belakiano/Ecovoz/caixa/desenho_tecnico.png

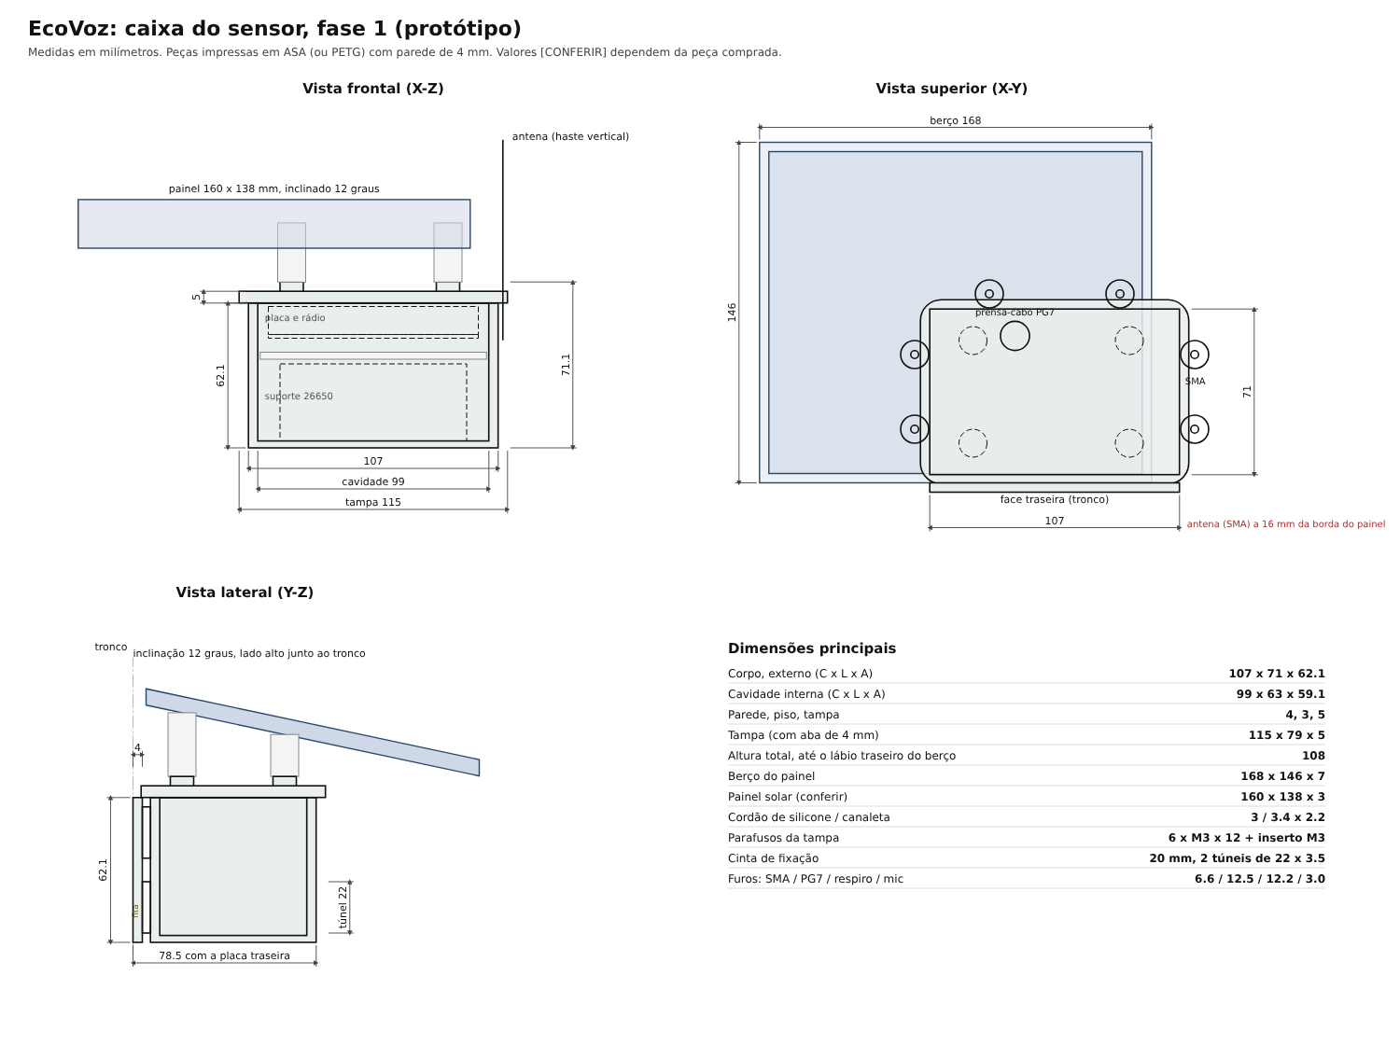
caixa/desenho_tecnico.png
