belakiano/Ecovoz/caixa/imagens/01_montada_frente.png

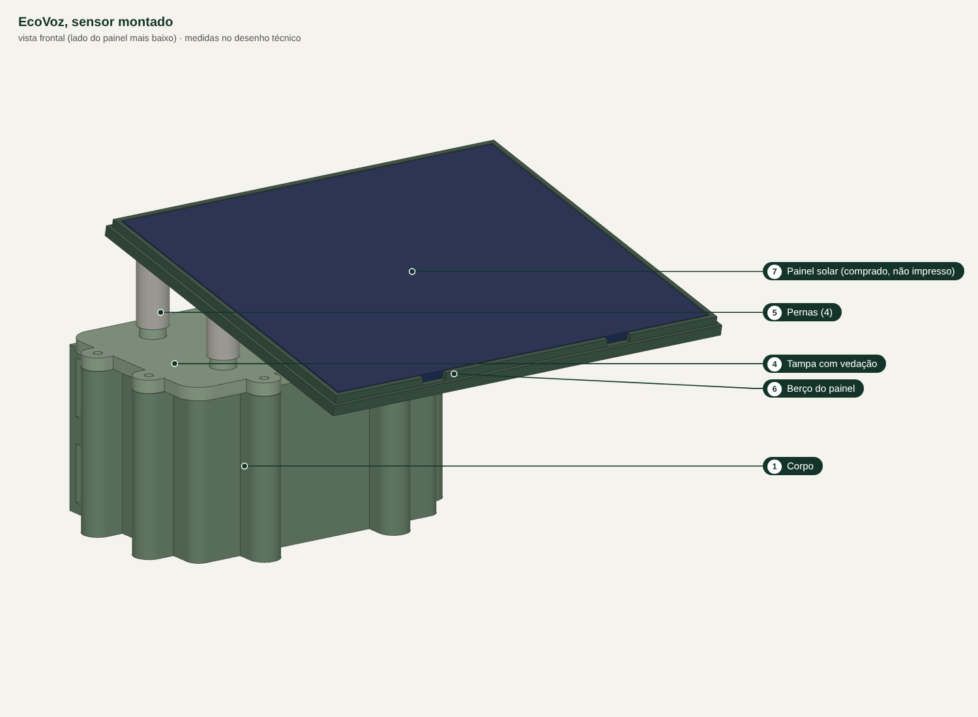
caixa/imagens/01_montada_frente.png
