belakiano/Ecovoz/caixa/imagens/02_montada_tras.png

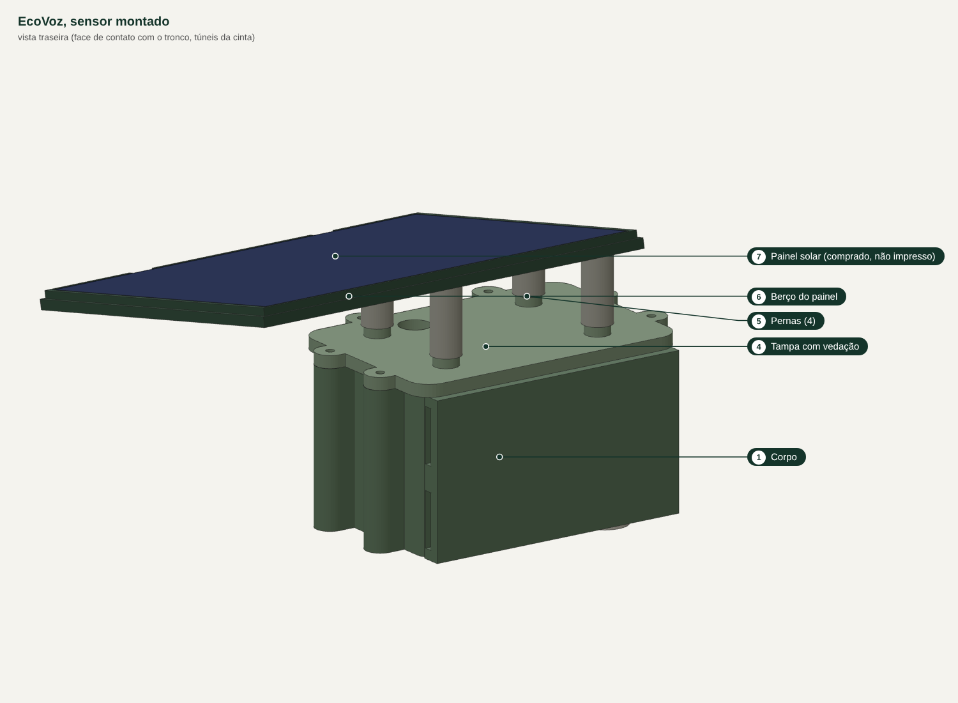
caixa/imagens/02_montada_tras.png
