belakiano/Ecovoz/caixa/imagens/04_aberta.png

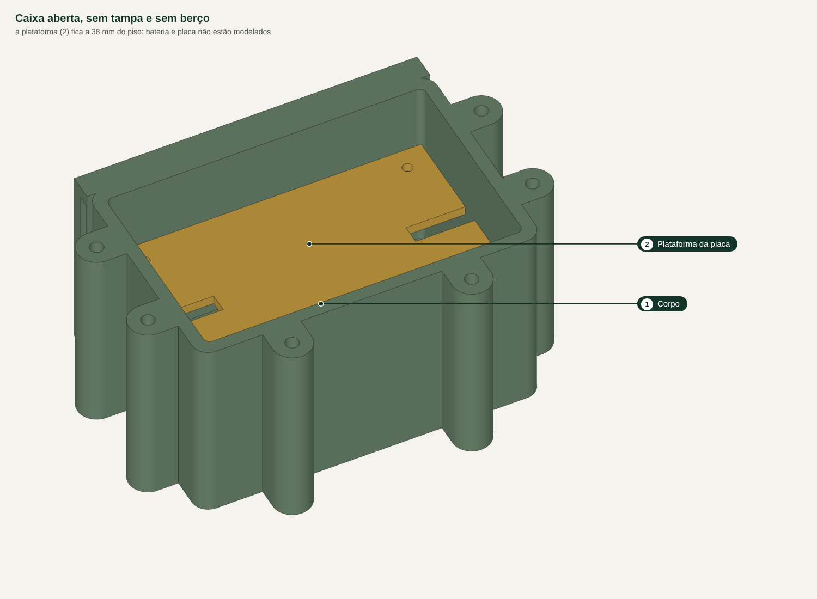
caixa/imagens/04_aberta.png
