belakiano/Ecovoz/docs/diagrama_operacao.png

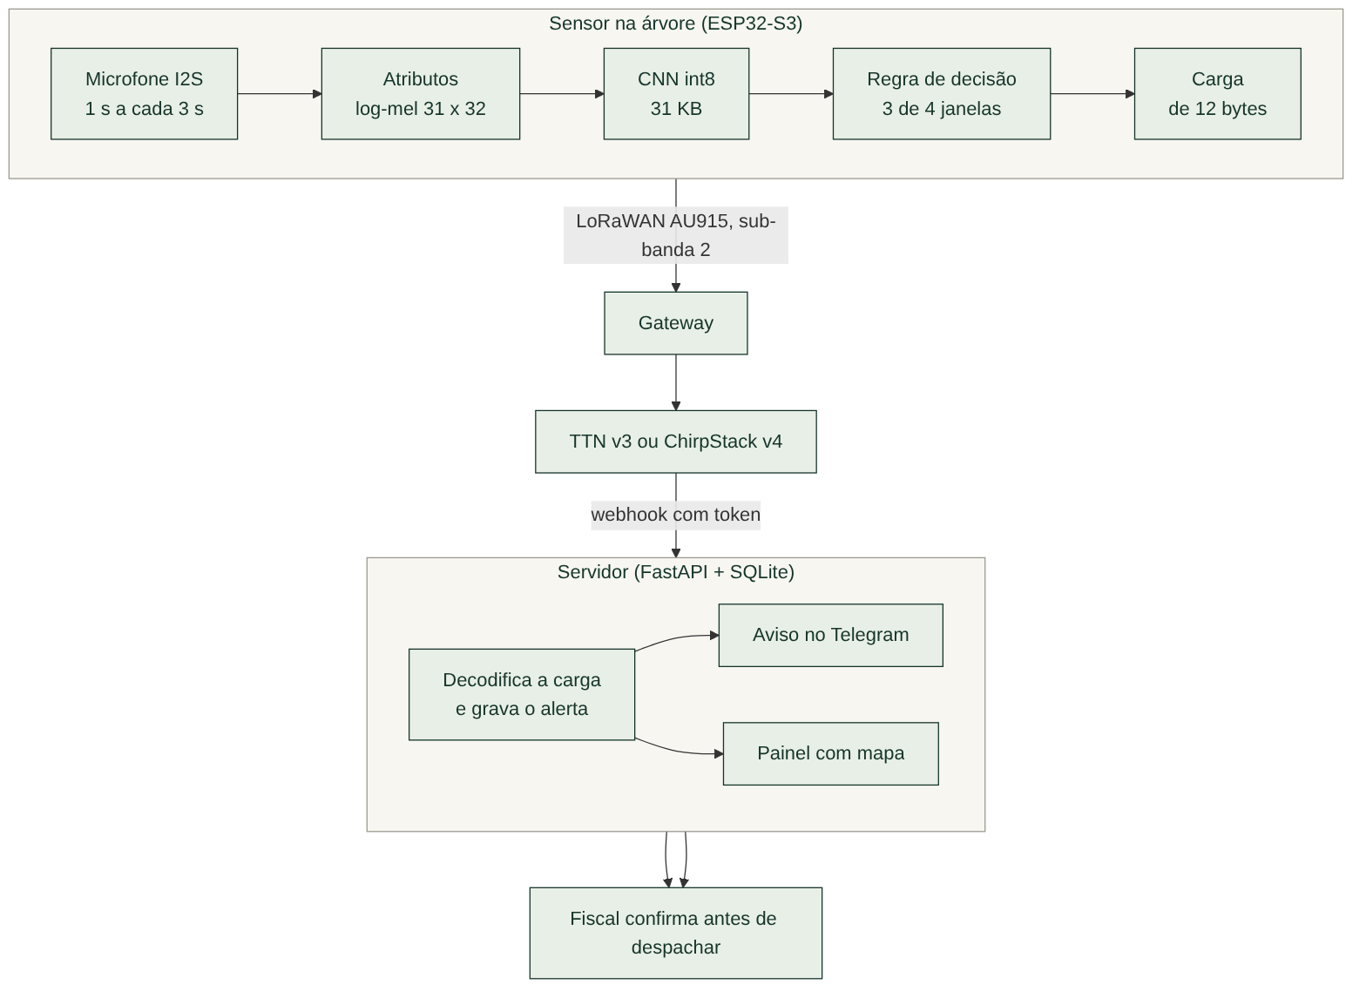
docs/diagrama_operacao.png
