belakiano/Ecovoz/caixa/lista_de_materiais.csv

Item | Especificação | Quantidade | Função | Observação | Preço unitário (R$) | Fonte e data da cotação
Controle | Placa de desenvolvimento ESP32-S3 (ex.: ESP32-S3-DevKitC-1) | 2 | Microcontrolador, inferência TinyML e controle do rádio | 1 de reserva. Na bancada o consumo da placa de desenvolvimento é muito maior que o do projeto final: medir só o chip depois.
Rádio | Módulo LoRa SX1262 915 MHz (ex.: Ebyte E22-900M22S) com cabo u.FL para SMA | 2 | Enlace LoRaWAN AU915 até o gateway | Conferir na folha de dados o TCXO e os pinos RXEN/TXEN.
Antena | Antena 915 MHz 3 dBi, haste flexível, conector SMA macho, com adaptador em ângulo reto | 2 | Irradiação do sinal | Instalada na vertical, acima da copa quando possível.
Conector | SMA fêmea de painel, vedado com anel O-ring, furo de 6,6 mm | 2 | Passagem da antena pela parede | Conferir o diâmetro de rosca do modelo comprado.
Microfone | Microfone MEMS I2S (INMP441 ou equivalente) em placa de 14 x 14 mm | 3 | Captação do áudio | 2 de reserva. Furo acústico de 3 mm.
Proteção acústica | Disco de membrana hidrofóbica de ePTFE, 9 mm, adesivo, e espuma de proteção contra vento de 14 mm | 6 + 3 | Impede água no microfone e reduz ruído de vento | Não vedar o furo com fita comum: abafa o som.
Posição | Módulo GNSS (ex.: u-blox NEO-M8N com antena cerâmica) | 1 | Marcar a posição na instalação (ligado só nessa hora) | Opcional na fase 1: a posição pode ser cadastrada pela serial.
Bateria | Célula LiFePO4 26650 de 3,2 V e cerca de 3000 mAh, com módulo de proteção | 2 | Armazenamento de energia | LiFePO4 tolera melhor calor e ciclos que íon-lítio comum. 1 de reserva.
Suporte da bateria | Suporte 1 x 26650 com fios | 2 | Fixação da célula (80 x 33 x 33 mm) | [CONFERIR] dimensões do suporte comprado.
Carregador solar | Módulo carregador com MPPT para LiFePO4 (candidato: baseado no bq24650, ajustado a 3,6 V) | 1 | Carga da bateria pelo painel | Candidato, conferir a folha de dados e o ajuste da tensão final de carga.
Regulador | Regulador buck-boost de 3,3 V e baixa corrente de repouso (candidato: TPS63802) | 1 | Alimentação do microcontrolador e do rádio | Candidato, conferir corrente de repouso medida na placa.
Proteção elétrica | Diodo supressor de surtos (TVS) na entrada solar e fusível rearmável de 1 A | 1 + 1 | Proteção contra surtos e curto
Painel solar | Painel de 6 V e 3 W, cerca de 160 x 138 x 3 mm, com fios | 1 | Geração de energia | [CONFERIR] medidas. O berço é parametrizado: se mudar o painel, altere caixa/parametros.py.
Placa universal | Placa perfurada ou de protótipo 90 x 56 mm | 2 | Montagem da eletrônica (fase 1) | A placa de circuito própria fica para a fase seguinte.
Espaçadores | Espaçador M3 de 6 mm, fêmea-fêmea, e parafuso M3 x 6 | 4 + 8 | Fixação da placa na plataforma
Impressão 3D | Filamento ASA (ou PETG) para uso externo, cor verde-oliva ou marrom fosca | ~0,4 kg | Corpo, tampa, plataforma, berço e pernas | Massa das peças estimada em 215 g com preenchimento de 25 a 40 por cento.
Inserto | Inserto roscado de latão M3 para fixação a quente (furo de 4,2 mm, 5 a 6 mm de comprimento) | 10 | 6 da tampa e 4 das pernas
Parafuso da tampa | Parafuso M3 x 12, aço inox | 6 | Fechamento da tampa
Parafuso das pernas, dianteiras | Parafuso M3 x 25, aço inox | 2 | Fixa berço e perna ao bloco da tampa | Alcance calculado 25.8 mm, furo cego de 6 mm de inserto.
Parafuso das pernas, traseiras | Parafuso M3 x 35, aço inox | 2 | Idem | Alcance calculado 35.2 mm. Conferir com paquímetro antes de apertar.
Vedação da tampa | Cordão redondo de silicone, diâmetro 3 mm | 0,4 m | Veda a tampa na canaleta de 3,4 x 2,2 mm | Cortar com 1 a 2 mm de sobra e emendar com cola de silicone.
Respiro | Respiro M12 x 1,5 com membrana de ePTFE | 1 | Equaliza a pressão e evita condensação sem entrar água | Furo de 12,2 mm na face +Y.
Prensa-cabo | Prensa-cabo PG7 com vedação | 1 | Passagem do cabo do painel | Furo de 12,5 mm na tampa.
Fixação à árvore | Cinta de nylon de 20 mm com fivela de came, 1,5 m | 1 | Prende a caixa ao tronco pelos túneis traseiros | Não usar prego nem parafuso no tronco.
Almofada | Adesivo de borracha EPDM de 3 mm, 105 x 40 mm | 1 | Ajuste da placa traseira ao tronco e antiderrapante
Colagem | Fita VHB (ou silicone neutro) para o painel e silicone neutro para vedação do cabo | 1 | Fixa o painel no berço
Secante | Sachê de sílica gel | 2 | Reduz umidade interna | Trocar a cada manutenção.
Cabos | Fio de silicone 22 AWG, conectores JST-PH e termorretrátil | 1 jogo | Ligações internas
Teste: energia | Medidor de corrente de baixa faixa (ex.: perfilador de corrente) ou multímetro com faixa de microampere | 1 | Medir consumo por modo (marco M5) | Sem isso a autonomia fica sem prova.
Teste: rádio | Gateway LoRaWAN AU915 (ou cobertura de gateway existente) e conta em servidor LoRaWAN | 1 | Marco M4 | Verificar sub-banda configurada.
Teste: áudio | Gravador de referência e fonte sonora de teste autorizada; calibrador acústico de 94 dB SPL (opcional) | 1 | Coletar dados próprios e calibrar o nível
