belakiano/Ecovoz/caixa/stl/anel_microfone.stl

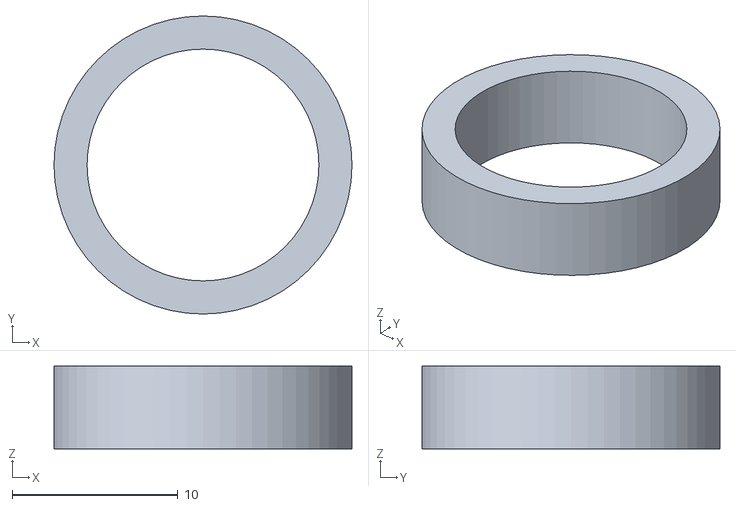
[picture p12: CAD file, 2026-11-03]
caixa/stl/anel_microfone.stl
18.0 x 18.0 x 5.00
