belakiano/Ecovoz/caixa/stl/berco_painel.stl

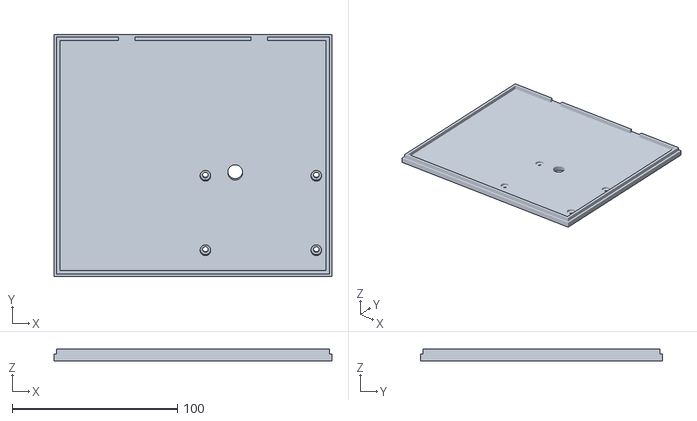
[picture p13: CAD file, 2026-11-03]
caixa/stl/berco_painel.stl
168.0 x 146.0 x 7.00
