belakiano/Ecovoz/caixa/stl/corpo.stl

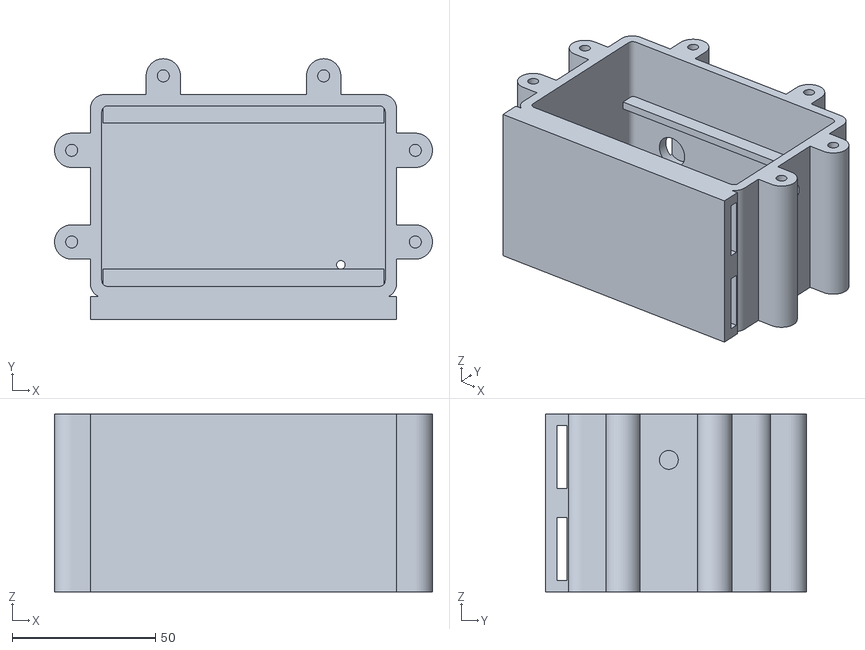
[picture p14: CAD file, 2026-11-03]
caixa/stl/corpo.stl
132.0 x 91.0 x 62.1
