belakiano/Ecovoz/caixa/stl/perna_dianteira.stl

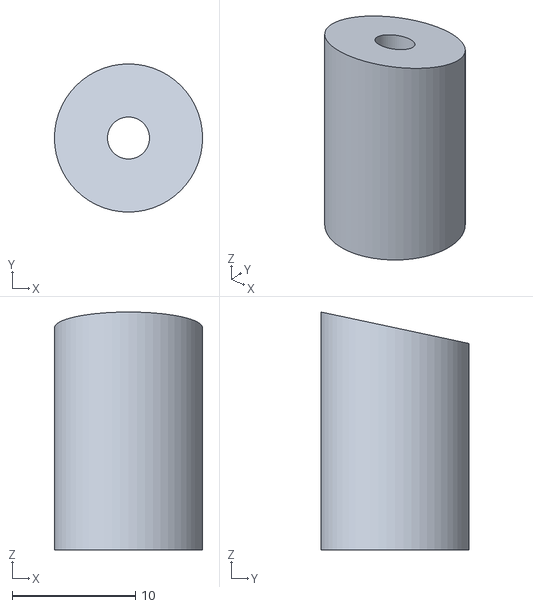
[picture p15: CAD file, 2026-11-03]
caixa/stl/perna_dianteira.stl
12.0 x 12.0 x 19.3
