belakiano/Ecovoz/caixa/stl/plataforma.stl

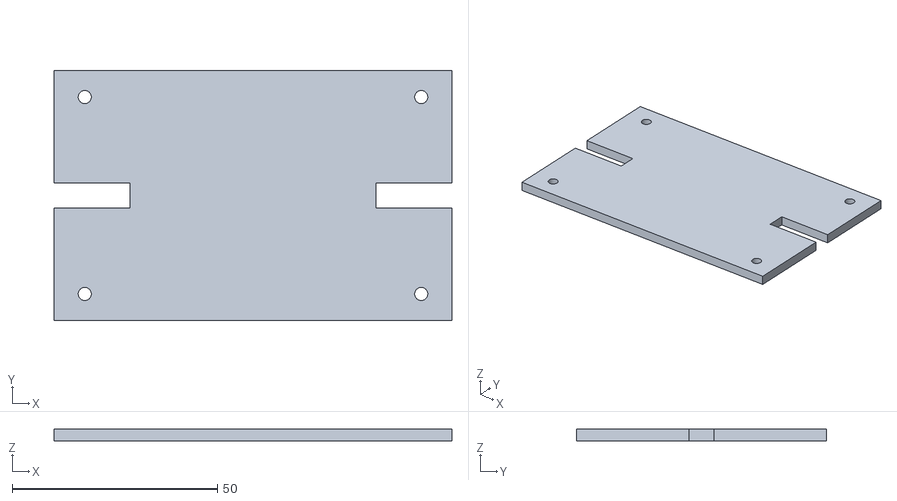
[picture p16: CAD file, 2026-11-03]
caixa/stl/plataforma.stl
97.0 x 61.0 x 3.00
