belakiano/Ecovoz/caixa/stl/tampa.stl

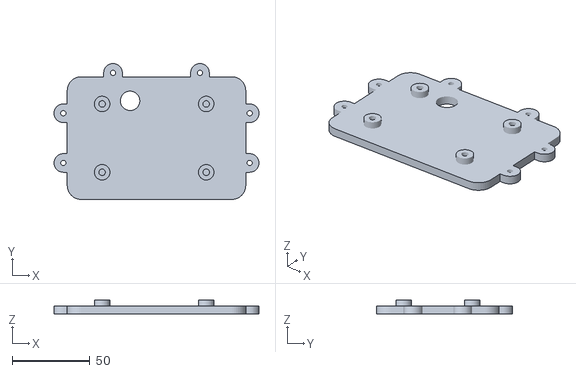
[picture p17: CAD file, 2026-11-03]
caixa/stl/tampa.stl
132.0 x 87.5 x 9.00
