belakiano/Ecovoz/caixa/stl/montagem_completa.stl

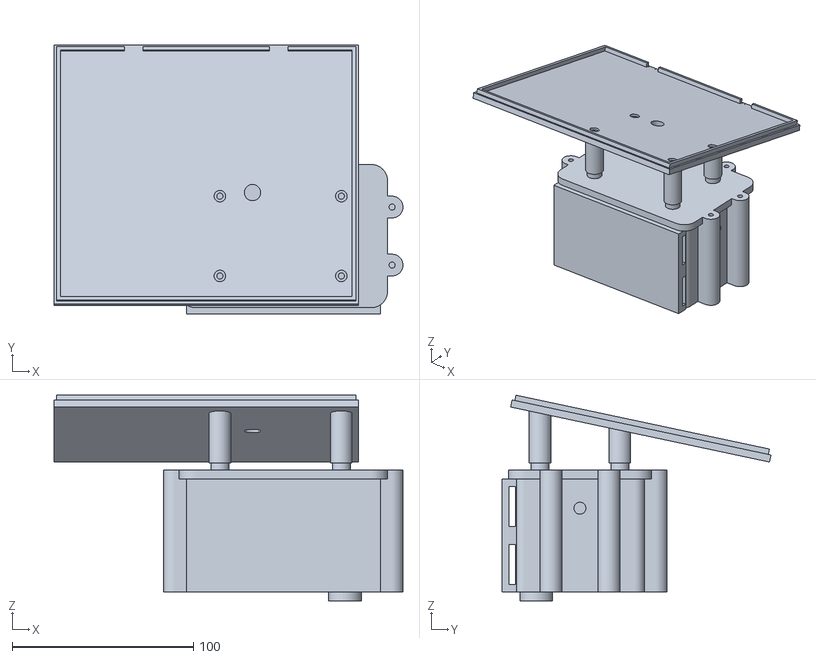
[picture p18: CAD file, 2026-11-03]
caixa/stl/montagem_completa.stl
192.5 x 148.4 x 113.4
