belakiano/Ecovoz/caixa/stl/perna_traseira.stl

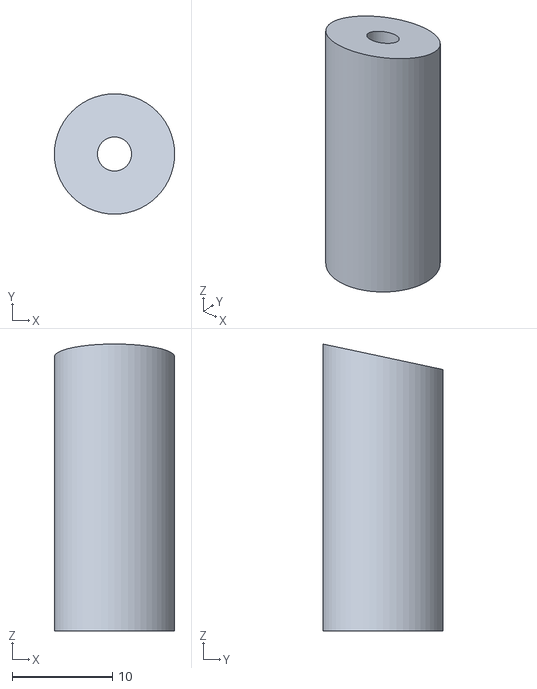
[picture p19: CAD file, 2026-11-03]
caixa/stl/perna_traseira.stl
12.0 x 12.0 x 28.6
