belakiano/Ecovoz/firmware/src/modelo_dados.h

// Gerado por treino/exportar.py. Não edite à mão.
#pragma once
#include <stdint.h>
constexpr float MODELO_ENTRADA_ESCALA = 2.569694072e-02f;
constexpr int MODELO_ENTRADA_ZP = 9;
constexpr float MODELO_SAIDA_ESCALA = 3.906250000e-03f;
constexpr int MODELO_SAIDA_ZP = -128;
#define OPS_DO_MODELO_N 5
#define OPS_DO_MODELO_ADICIONAR(r) do { (r).AddConv2D(); (r).AddDepthwiseConv2D(); (r).AddFullyConnected(); (r).AddMean(); (r).AddSoftmax(); } while (0)
// operações do modelo: CONV_2D, DEPTHWISE_CONV_2D, FULLY_CONNECTED, MEAN, SOFTMAX
constexpr unsigned int MODELO_TFLITE_TAM = 31864;
alignas(16) static const unsigned char modelo_tflite[] = {
  0x20,0x00,0x00,0x00,0x54,0x46,0x4c,0x33,0x00,0x00,0x00,0x00,0x14,0x00,0x20,0x00,
  0x1c,0x00,0x18,0x00,0x14,0x00,0x10,0x00,0x0c,0x00,0x00,0x00,0x08,0x00,0x04,0x00,
  0x14,0x00,0x00,0x00,0x1c,0x00,0x00,0x00,0x90,0x00,0x00,0x00,0xe8,0x00,0x00,0x00,
  0x3c,0x34,0x00,0x00,0x4c,0x34,0x00,0x00,0xcc,0x7b,0x00,0x00,0x03,0x00,0x00,0x00,
  0x01,0x00,0x00,0x00,0x10,0x00,0x00,0x00,0x00,0x00,0x0a,0x00,0x10,0x00,0x0c,0x00,
  0x08,0x00,0x04,0x00,0x0a,0x00,0x00,0x00,0x0c,0x00,0x00,0x00,0x1c,0x00,0x00,0x00,
  0x3c,0x00,0x00,0x00,0x0f,0x00,0x00,0x00,0x73,0x65,0x72,0x76,0x69,0x6e,0x67,0x5f,
  0x64,0x65,0x66,0x61,0x75,0x6c,0x74,0x00,0x01,0x00,0x00,0x00,0x04,0x00,0x00,0x00,
  0x98,0xff,0xff,0xff,0x21,0x00,0x00,0x00,0x04,0x00,0x00,0x00,0x08,0x00,0x00,0x00,
  0x6f,0x75,0x74,0x70,0x75,0x74,0x5f,0x30,0x00,0x00,0x00,0x00,0x01,0x00,0x00,0x00,
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
  0x4c,0x87,0xff,0xff,0x50,0x87,0xff,0xff,0x54,0x87,0xff,0xff,0x58,0x87,0xff,0xff,
  0x5c,0x87,0xff,0xff,0x5a,0xcd,0xff,0xff,0x04,0x00,0x00,0x00,0x90,0x00,0x00,0x00,
  0xe3,0x11,0x16,0x2c,0xbd,0x81,0xf1,0x2b,0x68,0x7f,0x08,0xb9,0x6d,0x17,0x94,0x0e,
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
};
