belakiano/Ecovoz/nucleo/tabelas_atributos.h

// Arquivo gerado por treino/gerar_tabelas.py. Não edite à mão.
#pragma once
#include <stdint.h>
namespace ecovoz {
constexpr int TAXA_HZ = 16000;
constexpr int JANELA = 16000;
constexpr int QUADRO = 512;
constexpr int PASSO = 500;
constexpr int N_FFT = 512;
constexpr int N_BINS = 257;
constexpr int N_MELS = 32;
constexpr int N_QUADROS = 31;
constexpr float PISO_LOG = 1.0e-08f;
static const float HANN[QUADRO] = {
0.000000000e+00f,3.764907888e-05f,1.505906548e-04f,3.388077021e-04f,6.022718735e-04f,9.409435443e-04f,1.354771666e-03f,1.843693899e-03f,2.407636726e-03f,3.046514932e-03f,3.760232590e-03f,4.548682366e-03f,5.411745049e-03f,6.349290721e-03f,7.361178752e-03f,8.447255939e-03f,9.607359767e-03f,1.084131468e-02f,1.214893535e-02f,1.353002433e-02f,1.498437300e-02f,1.651176438e-02f,1.811196655e-02f,1.978474110e-02f,2.152983285e-02f,2.334697917e-02f,2.523590997e-02f,2.719633654e-02f,2.922796831e-02f,3.133049235e-02f,3.350359946e-02f,3.574695811e-02f,3.806023300e-02f,4.044307396e-02f,4.289512336e-02f,4.541600868e-02f,4.800535366e-02f,5.066276714e-02f,5.338785052e-02f,5.618019029e-02f,5.903936923e-02f,6.196495146e-02f,6.495650113e-02f,6.801357120e-02f,7.113569230e-02f,7.432240248e-02f,7.757321745e-02f,8.088764548e-02f,8.426519483e-02f,8.770535141e-02f,9.120759368e-02f,9.477140009e-02f,9.839623421e-02f,1.020815447e-01f,1.058267877e-01f,1.096313894e-01f,1.134947762e-01f,1.174163669e-01f,1.213955805e-01f,1.254318058e-01f,1.295244396e-01f,1.336728632e-01f,1.378764659e-01f,1.421345919e-01f,1.464466155e-01f,1.508118808e-01f,1.552297324e-01f,1.596994996e-01f,1.642205268e-01f,1.687921137e-01f,1.734135747e-01f,1.780842245e-01f,1.828033626e-01f,1.875702590e-01f,1.923841983e-01f,1.972444803e-01f,2.021503448e-01f,2.071010768e-01f,2.120959014e-01f,2.171340883e-01f,2.222148776e-01f,2.273375094e-01f,2.325011939e-01f,2.377051562e-01f,2.429486215e-01f,2.482308149e-01f,2.535509169e-01f,2.589081228e-01f,2.64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
static const uint16_t MEL_INICIO[N_MELS] = {2,4,6,8,10,13,16,18,22,25,29,32,37,41,46,51,57,63,69,77,84,92,101,111,121,132,144,156,170,185,201,218};
static const uint16_t MEL_TAMANHO[N_MELS] = {4,4,4,5,6,5,6,7,7,7,8,9,9,10,11,12,12,14,15,15,17,19,20,21,23,24,26,29,31,33,36,39};
static const float MEL_PESOS[488] = {
2.161675543e-01f,7.565864325e-01f,7.242548466e-01f,2.225200534e-01f,2.757451832e-01f,7.774799466e-01f,7.407719493e-01f,2.749521732e-01f,2.592280805e-01f,7.250478268e-01f,8.227950335e-01f,3.903194368e-01f,1.772049665e-01f,6.096805930e-01f,9.608614445e-01f,5.593431592e-01f,1.578249186e-01f,3.913855180e-02f,4.406568110e-01f,8.421750665e-01f,7.737506628e-01f,4.009737372e-01f,2.819683217e-02f,2.262493521e-01f,5.990262628e-01f,9.718031883e-01f,6.800855398e-01f,3.339926302e-01f,3.199144602e-01f,6.660073400e-01f,9.887658954e-01f,6.674469113e-01f,3.461279273e-01f,2.480892278e-02f,1.123410463e-02f,3.325530887e-01f,6.538720727e-01f,9.751910567e-01f,7.247146368e-01f,4.263961911e-01f,1.280777603e-01f,2.752853632e-01f,5.736038089e-01f,8.719222546e-01f,8.419454098e-01f,5.649811625e-01f,2.880168557e-01f,1.105254330e-02f,1.580545604e-01f,4.350188673e-01f,7.119831443e-01f,9.889474511e-01f,7.531226873e-01f,4.959839284e-01f,2.388452142e-01f,2.468773425e-01f,5.040160418e-01f,7.611547709e-01f,9.830159545e-01f,7.442836761e-01f,5.055513382e-01f,2.668190598e-01f,2.808676288e-02f,1.698403433e-02f,2.557163239e-01f,4.944486320e-01f,7.331809402e-01f,9.719132185e-01f,8.044328094e-01f,5.827893615e-01f,3.611459434e-01f,1.395025104e-01f,1.955671757e-01f,4.172106087e-01f,6.388540268e-01f,8.604974747e-01f,9.237388372e-01f,7.179610133e-01f,5.121831894e-01f,3.064053655e-01f,1.006275415e-01f,7.626114786e-02f,2.820389867e-01f,4.878168106e-01f,6.935946345e-01f,8.993724585e-01f,9.023765326e-01f,7.113286257e-01f,5.20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
}  // namespace ecovoz
