belakiano/Ecovoz/firmware/src/segredos.exemplo.h

// Copie para segredos.h e preencha com as chaves do dispositivo gerado no console LoRaWAN. NÃO versione segredos.h.
#pragma once
#include <stdint.h>
static const uint64_t JOIN_EUI = 0x0000000000000000ULL;
static const uint64_t DEV_EUI  = 0x0000000000000000ULL;
static uint8_t NWK_KEY[16] = {0};
static uint8_t APP_KEY[16] = {0};
